DomeGitHub101/Camera_STM32/tools/tags/tag36h11_id6.png

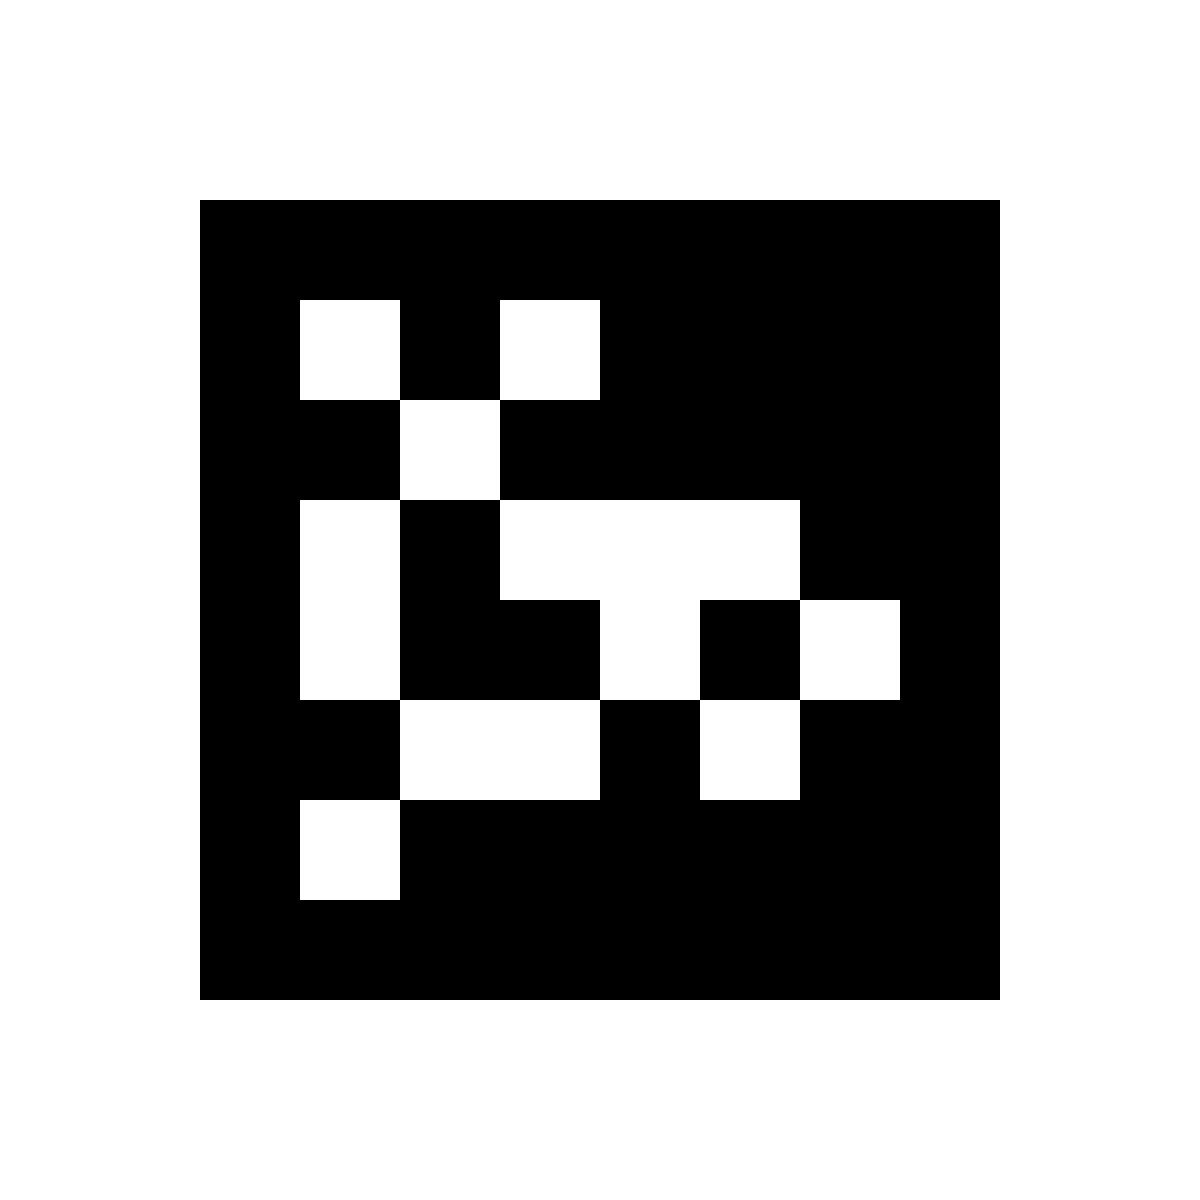
tools/tags/tag36h11_id6.png
