DomeGitHub101/Camera_STM32/tools/thai_text_preview.png

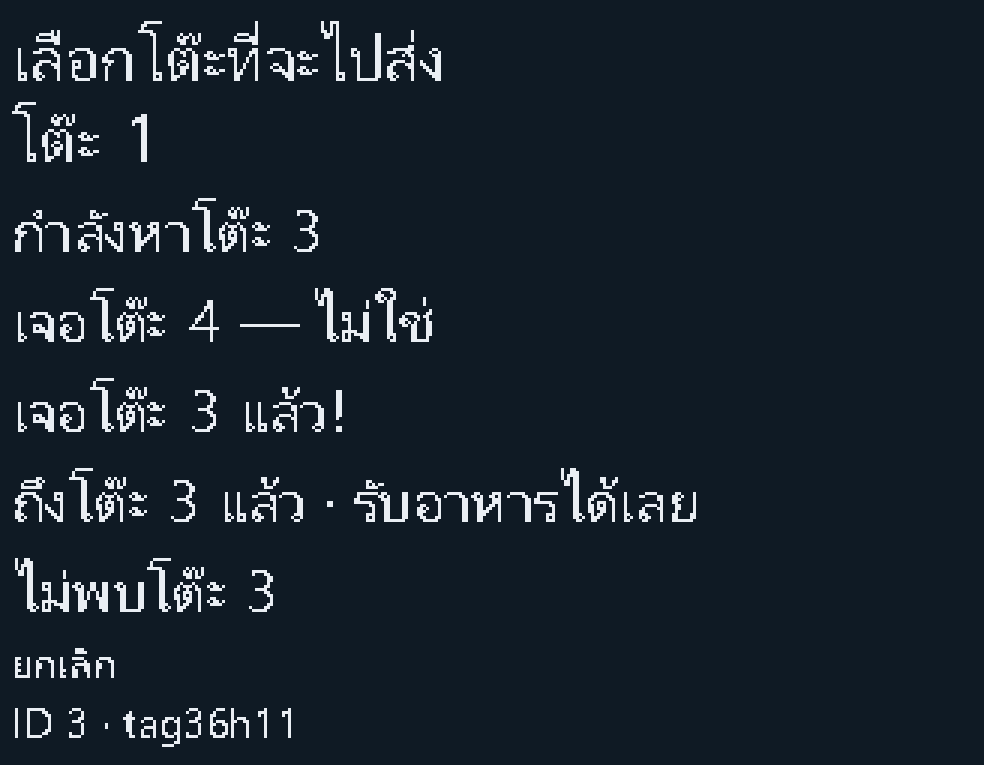
tools/thai_text_preview.png
