DomeGitHub101/Camera_STM32/Core/Src/main.c

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
/* Includes ------------------------------------------------------------------*/
#include "main.h"
#include "dcmi.h"
#include "dma.h"
#include "i2c.h"
#include "spi.h"
#include "tim.h"
#include "usart.h"
#include "gpio.h"

/* USER CODE BEGIN Includes */
#include "ov7670.h"
#include "apriltag_lite.h"
#include <stdio.h>
#include <stdlib.h>
#include <string.h>
#include "tim.h"
#include "delivery.h"
#include "cat_ui.h"
/* USER CODE END Includes */

/* USER CODE BEGIN PD */
/* ---- application ---- */
#define APP_DELIVERY       1        /* 1 = table delivery on the LCD (cat face, touch, servo, link_send)
                                       0 = tag -> command + video for tools/ov7670_viewer.py */
#define DELIVERY_VIDEO     1        /* 1 = delivery mode also sends video to the viewer (needs 2 Mbaud) */
/* ---- serial port (ST-LINK USB) ---- */
#if APP_DELIVERY && !DELIVERY_VIDEO
#define UART_BAUD          115200   /* text only (no video) */
#else
#define UART_BAUD          2000000  /* Tera Term and tools/ov7670_viewer.py must use this speed.
                                       2 Mbaud = 54 MHz / 27 exactly. Garbage? use 921600 */
#endif
/* ---- AprilTag (tag36h11) detection on the STM32 ---- */
#define DET_SCALE          1        /* 1 = detect on 320x240 (longer range), 2 = on 160x120 (faster) */
#define DET_W              (OV7670_WIDTH / DET_SCALE)
#define DET_H              (OV7670_HEIGHT / DET_SCALE)
#define CONFIRM_FRAMES     2        /* a tag must be seen this many frames in a row to become the command */
#define TAG_LOST_MS        1000     /* no command tag for this long -> STOP */
/* ---- result lines in Tera Term ---- */
#define OUTPUT_DELAY_MS    500      /* delay between result lines; change at run time with + and - */
#define OUTPUT_DELAY_STEP  100
#define OUTPUT_DELAY_MIN   100
#define OUTPUT_DELAY_MAX   10000
/* ---- live video for tools/ov7670_viewer.py (sent only after it asks with 'v') ---- */
#define VIDEO_SCALE        2        /* 1 = 320x240, 2 = 160x120; must be a multiple of DET_SCALE */
#define VIDEO_W            (OV7670_WIDTH / VIDEO_SCALE)
#define VIDEO_H            (OV7670_HEIGHT / VIDEO_SCALE)
/* ---- misc ---- */
#define BOOT_DIAG          0        /* 1 = print the SCCB / I2C scan / sync-signal tests at start-up */
#define GRAY_Y_OFFSET      0        /* which byte of each YUYV pixel pair is Y */
/* ---- camera signal checks ---- */
#define OV7670_TEST_PATTERN 0       /* 1 = colour bars instead of the picture (key p toggles at run time) */
#define OV7670_PCLK_DIV    1        /* 1 = normal, 2 / 4 = slower PCLK for long jumper wires (fewer fps) */
#define CAMERA_ROTATION    180      /* how far to turn the picture clockwise to make it upright: 0 / 90 / 180 / 270.
                                       0 = camera mounted level (landscape). If it is mounted on its side,
                                       the left/right angle is taken from the matching image axis and
                                       the viewer turns the picture (detection works in any orientation) */
#define CAM_STATS          0        /* 1 = print a CAM: line (frame size / errors) with every result line */
#define DROP_BAD_FRAMES    1        /* 1 = no tag detection on frames with wrong size or DCMI errors */
#define SHOW_BAD_FRAMES    0        /* 1 = the viewer also gets the bad frames (stripes / shifted lines) */
#define FRAME_MARGIN       (4 * OV7670_WIDTH * 2)   /* DMA room for 4 extra lines, to measure long frames */
#define CAP_BYTES          (OV7670_FRAME_BYTES + FRAME_MARGIN)
#define ROW_TOLERANCE      12       /* test pattern: mean |Y difference| for a row to count as wrong */

#if (VIDEO_SCALE % DET_SCALE) != 0
#error "VIDEO_SCALE must be a multiple of DET_SCALE"
#endif
/* USER CODE END PD */


/* USER CODE BEGIN PV */
__attribute__((aligned(32))) static uint8_t frame_buf[CAP_BYTES];   /* YUYV from the DCMI */
static uint8_t           cap_running = 0;  /* a snapshot has been started and not yet collected */
static volatile uint16_t cap_lines = 0;    /* lines (HREF pulses) received in the current snapshot */
static volatile uint32_t cap_err = 0;      /* HAL_DCMI_ERROR_* bits seen during the current snapshot */
static uint8_t           test_pattern = OV7670_TEST_PATTERN;
static uint8_t gray[DET_W * DET_H];            /* Y plane = input of the tag detector */
static uint8_t video_buf[VIDEO_W * VIDEO_H];   /* frame sent to the PC viewer */
static at_config_t    at_cfg;
static at_detection_t dets[AT_MAX_DETECT];

/* Tag ID -> robot command (other IDs are reported but give no command) */
static const char *const tag_cmd[] = {
  "STOP",         /* ID 0 */
  "FORWARD",      /* ID 1 */
  "TURN_LEFT",    /* ID 2 */
  "TURN_RIGHT",   /* ID 3 */
  "BACKWARD",     /* ID 4 */
};
#define NUM_TAG_CMDS ((int)(sizeof tag_cmd / sizeof tag_cmd[0]))

static int      active_id = -1;       /* tag ID currently driving the robot, -1 = none */
__attribute__((unused)) static int cand_id = -1;       /* tag waiting for CONFIRM_FRAMES */
__attribute__((unused)) static int cand_count = 0;
static uint32_t active_seen = 0;      /* tick when the active tag was last seen */
static uint8_t  video_mode = 0;       /* 1 = viewer connected: also send frames + @ lines */
static uint32_t output_delay = OUTPUT_DELAY_MS;

/* statistics for the result lines */
static uint32_t stat_frames = 0, stat_det_us = 0, stat_t0 = 0;
static int            last_n = 0;     /* tags found in the latest frame */
static at_detection_t last_best;      /* biggest of them */

/* frame checks since the last result line */
static struct {
  uint32_t frames, good, short_, long_, ovr, other_err, timeout;
  uint32_t lines_min, lines_max, bytes_min, bytes_max;
  uint32_t row_bad_frames, rows_bad_max, order_ok, order_bad;
} cam;
/* USER CODE END PV */

void SystemClock_Config(void);
static void MPU_Config(void);
/* USER CODE BEGIN 0 */
static void uart_print(const char *s)
{
  HAL_UART_Transmit(&huart3, (uint8_t *)s, strlen(s), 100);
}

/* Non-blocking read of one byte typed in Tera Term / sent by the viewer, -1 if none */
static int uart_getc(void)
{
  USART_TypeDef *u = huart3.Instance;
  if (u->ISR & (USART_ISR_ORE | USART_ISR_FE | USART_ISR_NE))
    u->ICR = USART_ICR_ORECF | USART_ICR_FECF | USART_ICR_NCF;
  if (u->ISR & USART_ISR_RXNE) return (int)(u->RDR & 0xFF);
  return -1;
}

/* ---- SCCB bit-bang: bus recovery at start-up (+ register test with BOOT_DIAG) ---- */
#define BB_SCL_PIN  GPIO_PIN_1   /* PF1 */
#define BB_SDA_PIN  GPIO_PIN_0   /* PF0 */
#define SCL_H()  HAL_GPIO_WritePin(GPIOF, BB_SCL_PIN, GPIO_PIN_SET)
#define SCL_L()  HAL_GPIO_WritePin(GPIOF, BB_SCL_PIN, GPIO_PIN_RESET)
#define SDA_H()  HAL_GPIO_WritePin(GPIOF, BB_SDA_PIN, GPIO_PIN_SET)
#define SDA_L()  HAL_GPIO_WritePin(GPIOF, BB_SDA_PIN, GPIO_PIN_RESET)
#define SDA_IN() (HAL_GPIO_ReadPin(GPIOF, BB_SDA_PIN) == GPIO_PIN_SET)
#define SCL_IN() (HAL_GPIO_ReadPin(GPIOF, BB_SCL_PIN) == GPIO_PIN_SET)

static void bb_delay(void)
{
  for (volatile uint32_t i = 0; i < 1000; i++) {}   /* ~5 us at 216 MHz */
}

static void bb_init(void)
{
  GPIO_InitTypeDef g = {0};
  HAL_I2C_DeInit(&hi2c2);
  __HAL_RCC_GPIOF_CLK_ENABLE();
  g.Pin = BB_SCL_PIN | BB_SDA_PIN;
  g.Mode = GPIO_MODE_OUTPUT_OD;
  g.Pull = GPIO_PULLUP;
  g.Speed = GPIO_SPEED_FREQ_LOW;
  SCL_H(); SDA_H();
  HAL_GPIO_Init(GPIOF, &g);
  bb_delay();
}

/* Bus recovery: if the camera still holds SDA low (MCU was reset in the
   middle of a transfer), clock SCL until it lets go, then send a STOP */
static void bb_recover(void)
{
  for (int i = 0; i < 9 && !SDA_IN(); i++) {
    SCL_L(); bb_delay(); SCL_H(); bb_delay();
  }
  SDA_L(); bb_delay(); SCL_H(); bb_delay(); SDA_H(); bb_delay();
}

#if BOOT_DIAG
static void bb_start(void) { SDA_H(); SCL_H(); bb_delay(); SDA_L(); bb_delay(); SCL_L(); bb_delay(); }
static void bb_stop(void)  { SDA_L(); bb_delay(); SCL_H(); bb_delay(); SDA_H(); bb_delay(); }

static int bb_write(uint8_t b)
{
  for (int i = 7; i >= 0; i--) {
    if (b & (1 << i)) SDA_H(); else SDA_L();
    bb_delay(); SCL_H(); bb_delay(); SCL_L(); bb_delay();
  }
  SDA_H(); bb_delay();
  SCL_H(); bb_delay();
  int ack = !SDA_IN();
  SCL_L(); bb_delay();
  return ack;
}

static uint8_t bb_read(void)
{
  uint8_t b = 0;
  SDA_H();
  for (int i = 0; i < 8; i++) {
    bb_delay(); SCL_H(); bb_delay();
    b = (b << 1) | (SDA_IN() ? 1 : 0);
    SCL_L();
  }
  SDA_H(); bb_delay(); SCL_H(); bb_delay(); SCL_L(); bb_delay();
  return b;
}

static void bb_read_reg(uint8_t reg, char *msg, size_t n)
{
  bb_start();
  int a1 = bb_write(0x42);
  int a2 = bb_write(reg);
  bb_stop();
  bb_start();
  int a3 = bb_write(0x43);
  uint8_t v = bb_read();
  bb_stop();
  snprintf(msg, n, "  reg 0x%02X: ACK addrW=%d reg=%d addrR=%d  value=0x%02X\r\n",
           reg, a1, a2, a3, v);
}

/* Count level changes on an input pin for 'ms' milliseconds (works in AF mode too) */
static uint32_t count_edges(GPIO_TypeDef *port, uint16_t pin, uint32_t ms)
{
  uint32_t n = 0, t0 = HAL_GetTick();
  uint32_t last = port->IDR & pin;
  while (HAL_GetTick() - t0 < ms) {
    uint32_t now = port->IDR & pin;
    if (now != last) { n++; last = now; }
  }
  return n;
}
#endif /* BOOT_DIAG */

/* ---- camera frames ----
   A snapshot is started into a buffer a few lines bigger than a frame, so
   the DMA never completes on a normal frame. The end of the frame is seen
   in the main loop when the DCMI clears CAPTURE; the DMA counter then tells
   how many bytes arrived, and the line interrupt how many lines. */
void HAL_DCMI_LineEventCallback(DCMI_HandleTypeDef *h)
{
  if (h->Instance->CR & DCMI_CR_CAPTURE) cap_lines++;
}

/* VSYNC starts the blanking before a frame: lines counted so far belong to
   the frame that was running when the snapshot was armed. At the end of the
   captured frame CAPTURE is already clear, so its count is kept. */
void HAL_DCMI_VsyncEventCallback(DCMI_HandleTypeDef *h)
{
  if (h->Instance->CR & DCMI_CR_CAPTURE) cap_lines = 0;
}

void HAL_DCMI_ErrorCallback(DCMI_HandleTypeDef *h)
{
  cap_err |= h->ErrorCode;
  h->ErrorCode = HAL_DCMI_ERROR_NONE;
}

static void start_capture(void)
{
  cap_lines = 0;
  cap_err = 0;
  HAL_DCMI_Start_DMA(&hdcmi, DCMI_MODE_SNAPSHOT, (uint32_t)frame_buf, CAP_BYTES / 4);
  /* the HAL turns these off after a frame event in snapshot mode */
  __HAL_DCMI_ENABLE_IT(&hdcmi, DCMI_IT_LINE | DCMI_IT_VSYNC | DCMI_IT_OVR | DCMI_IT_ERR);
  cap_running = 1;
}

/* Bytes the DMA took from the DCMI in this snapshot (call once CAPTURE is clear) */
static uint32_t captured_bytes(void)
{
  uint32_t t0 = DWT->CYCCNT;
  /* let the DMA empty the DCMI FIFO, at most ~100 us */
  while ((hdcmi.Instance->SR & DCMI_SR_FNE) && DWT->CYCCNT - t0 < SystemCoreClock / 10000u) {}
  return (CAP_BYTES / 4 - __HAL_DMA_GET_COUNTER(hdcmi.DMA_Handle)) * 4;
}

/* Test pattern: number of rows whose Y values differ from the middle row
   (the colour bars are vertical, so every row should be the same) */
static uint32_t count_bad_rows(void)
{
  const uint8_t *ref = frame_buf + (OV7670_HEIGHT / 2) * OV7670_WIDTH * 2 + GRAY_Y_OFFSET;
  uint32_t bad = 0;
  for (int y = 0; y < OV7670_HEIGHT; y++) {
    const uint8_t *row = frame_buf + y * OV7670_WIDTH * 2 + GRAY_Y_OFFSET;
    uint32_t diff = 0;
    for (int x = 0; x < OV7670_WIDTH * 2; x += 2) diff += (uint32_t)abs(row[x] - ref[x]);
    if (diff > ROW_TOLERANCE * OV7670_WIDTH) bad++;
  }
  return bad;
}

/* Test pattern: the first bar is white and the last black (or the other way
   round when mirrored). Both have U = V = 128, so with the right byte order
   the Y bytes differ a lot and the U/V bytes stay near 128. */
static int yuyv_order_ok(void)
{
  uint32_t y_l = 0, y_r = 0, c_l = 0, c_r = 0, n = 0;
  for (int y = 40; y < OV7670_HEIGHT - 40; y += 8)
    for (int x = 4; x < 20; x++) {
      const uint8_t *row = frame_buf + y * OV7670_WIDTH * 2;
      int xr = OV7670_WIDTH - 1 - x;
      y_l += row[x * 2 + GRAY_Y_OFFSET];
      c_l += row[x * 2 + 1 - GRAY_Y_OFFSET];
      y_r += row[xr * 2 + GRAY_Y_OFFSET];
      c_r += row[xr * 2 + 1 - GRAY_Y_OFFSET];
      n++;
    }
  y_l /= n; y_r /= n; c_l /= n; c_r /= n;
  return abs((int)y_l - (int)y_r) > 80 && abs((int)c_l - 128) < 30 && abs((int)c_r - 128) < 30;
}

/* Record the checks of one finished snapshot; 1 = frame is good */
static int check_frame(uint32_t bytes, uint32_t lines, uint32_t err)
{
  if (cam.frames == 0) {
    cam.lines_min = cam.lines_max = lines;
    cam.bytes_min = cam.bytes_max = bytes;
  }
  cam.frames++;
  if (lines < cam.lines_min) cam.lines_min = lines;
  if (lines > cam.lines_max) cam.lines_max = lines;
  if (bytes < cam.bytes_min) cam.bytes_min = bytes;
  if (bytes > cam.bytes_max) cam.bytes_max = bytes;

  int good = 1;
  if (bytes >= CAP_BYTES || lines > OV7670_HEIGHT) {
    /* also raises an overrun once the buffer is full: not counted separately */
    cam.long_++;
    good = 0;
  } else {
    if (err & HAL_DCMI_ERROR_OVR) { cam.ovr++; good = 0; }
    /* the HAL aborts the DMA after an overrun, which also sets ERROR_DMA */
    if ((err & HAL_DCMI_ERROR_SYNC) || (err & (HAL_DCMI_ERROR_DMA | HAL_DCMI_ERROR_OVR)) == HAL_DCMI_ERROR_DMA) {
      cam.other_err++;
      good = 0;
    }
    if (bytes != OV7670_FRAME_BYTES || lines != OV7670_HEIGHT) {
      if (bytes < OV7670_FRAME_BYTES || lines < OV7670_HEIGHT) cam.short_++;
      else cam.long_++;
      good = 0;
    }
  }

  if (test_pattern && bytes >= OV7670_FRAME_BYTES) {
    uint32_t rows = count_bad_rows();
    if (rows) { cam.row_bad_frames++; good = 0; }
    if (rows > cam.rows_bad_max) cam.rows_bad_max = rows;
    if (yuyv_order_ok()) cam.order_ok++;
    else cam.order_bad++;
  }
  if (good) cam.good++;
  return good;
}

__attribute__((unused)) static void print_cam_stats(void)
{
  char line[256];
  int len = snprintf(line, sizeof line,
                     "  CAM: %lu frames, %lu good | short %lu long %lu overrun %lu err %lu timeout %lu",
                     (unsigned long)cam.frames, (unsigned long)cam.good, (unsigned long)cam.short_,
                     (unsigned long)cam.long_, (unsigned long)cam.ovr, (unsigned long)cam.other_err,
                     (unsigned long)cam.timeout);
  if (cam.frames)
    len += snprintf(line + len, sizeof line - len, " | lines %lu-%lu (want %d) bytes %lu-%lu (want %d)",
                    (unsigned long)cam.lines_min, (unsigned long)cam.lines_max, OV7670_HEIGHT,
                    (unsigned long)cam.bytes_min, (unsigned long)cam.bytes_max, OV7670_FRAME_BYTES);
  if (test_pattern)
    len += snprintf(line + len, sizeof line - len, " | TEST bad-row frames %lu (max %lu rows), YUYV order %s",
                    (unsigned long)cam.row_bad_frames, (unsigned long)cam.rows_bad_max,
                    cam.order_bad == 0 ? "OK" : (cam.order_ok == 0 ? "WRONG" : "unstable"));
  snprintf(line + len, sizeof line - len, "\r\n");
  uart_print(line);
  memset(&cam, 0, sizeof cam);
}

/* VSYNC (PG9) period in microseconds, median of 5; 0 = no VSYNC */
static uint32_t measure_frame_us(void)
{
  uint32_t per[5], n = 0, t_prev = 0, t0 = HAL_GetTick();
  uint32_t last = GPIOG->IDR & GPIO_PIN_9;
  int edges = 0;
  while (n < 5 && HAL_GetTick() - t0 < 2000) {
    uint32_t now = GPIOG->IDR & GPIO_PIN_9;
    if (now && !last) {
      uint32_t t = DWT->CYCCNT;
      uint32_t us = (t - t_prev) / (SystemCoreClock / 1000000u);
      if (edges++ > 0 && us > 5000) per[n++] = us;   /* ignore glitches */
      t_prev = t;
    }
    last = now;
  }
  if (n < 5) return 0;
  for (int i = 1; i < 5; i++)                         /* sort, take the middle one */
    for (int j = i; j > 0 && per[j] < per[j - 1]; j--) { uint32_t s = per[j]; per[j] = per[j - 1]; per[j - 1] = s; }
  return per[2];
}

/* Copy the Y bytes of the YUYV frame into gray[] (every DET_SCALE-th pixel and line) */
static void extract_gray(void)
{
  uint8_t *dst = gray;
  for (int y = 0; y < OV7670_HEIGHT; y += DET_SCALE) {
    const uint8_t *src = frame_buf + y * OV7670_WIDTH * 2 + GRAY_Y_OFFSET;
    for (int x = 0; x < OV7670_WIDTH; x += DET_SCALE) *dst++ = src[x * 2];
  }
}

/* ---- tag -> command ---- */
__attribute__((unused)) static const char *cmd_text(int id)
{
  if (id < 0) return "STOP (no tag)";
  return tag_cmd[id];
}

#if !APP_DELIVERY
/* id = biggest tag with a command in this frame, -1 = none */
static void update_command(int id, uint32_t now)
{
  if (id < 0) {
    cand_id = -1;
    cand_count = 0;
    return;
  }
  if (id == cand_id) cand_count++;
  else { cand_id = id; cand_count = 1; }
  if (cand_count >= CONFIRM_FRAMES) active_id = id;
  if (id == active_id) active_seen = now;
}

/* One result line for Tera Term, every output_delay ms */
static void print_status(uint32_t now)
{
  char line[160];
  uint32_t dt = now - stat_t0;
  uint32_t fps10 = dt ? stat_frames * 10000u / dt : 0;                  /* fps x10 */
  uint32_t det10 = stat_frames ? stat_det_us / stat_frames / 100u : 0;  /* ms x10 */
  int len = snprintf(line, sizeof line, "[%6lu.%02lu s] CMD: %-13s | ",
                     (unsigned long)(now / 1000), (unsigned long)(now % 1000 / 10), cmd_text(active_id));
  if (last_n > 0)
    len += snprintf(line + len, sizeof line - len, "tag ID %d at (%d,%d) %dpx rot %d err %d%s | ",
                    last_best.id, (int)last_best.cx, (int)last_best.cy, (int)(last_best.side + 0.5f),
                    last_best.rotation, last_best.hamming, last_n > 1 ? " +more" : "");
  else
    len += snprintf(line + len, sizeof line - len, "no tag | ");
  snprintf(line + len, sizeof line - len, "detect %lu.%lu ms, %lu.%lu fps\r\n",
           (unsigned long)(det10 / 10), (unsigned long)(det10 % 10),
           (unsigned long)(fps10 / 10), (unsigned long)(fps10 % 10));
  uart_print(line);
#if CAM_STATS
  print_cam_stats();
#endif
  stat_frames = 0;
  stat_det_us = 0;
  stat_t0 = now;
}
#endif /* !APP_DELIVERY */

static void print_help(void)
{
  char line[100];
#if !APP_DELIVERY
  uart_print("tag ID -> command: 0 STOP, 1 FORWARD, 2 TURN_LEFT, 3 TURN_RIGHT, 4 BACKWARD\r\n");
#endif
  snprintf(line, sizeof line, "output delay %lu ms  (keys: + slower, - faster, p test pattern, s servo test, h help)\r\n",
           (unsigned long)output_delay);
  uart_print(line);
}

/* Keys from Tera Term (+ - h) and from the viewer (v = video on, t = text only) */
static void handle_key(int c)
{
  char line[60];
  switch (c) {
  case 'v':
#if APP_DELIVERY && !DELIVERY_VIDEO
    uart_print("@MODE TEXT\r\n");   /* no video at 115200 baud: the viewer shows the text lines */
#else
    video_mode = 1;
#endif
    break;
  case 't':
    video_mode = 0;
    uart_print("\r\nvideo off\r\n");
    break;
  case '+':
  case '-':
    if (c == '+' && output_delay + OUTPUT_DELAY_STEP <= OUTPUT_DELAY_MAX) output_delay += OUTPUT_DELAY_STEP;
    if (c == '-' && output_delay >= OUTPUT_DELAY_MIN + OUTPUT_DELAY_STEP) output_delay -= OUTPUT_DELAY_STEP;
    snprintf(line, sizeof line, "output delay = %lu ms\r\n", (unsigned long)output_delay);
    uart_print(line);
    break;
  case 'p':
    test_pattern = !test_pattern;
    OV7670_SetTestPattern(test_pattern);
    uart_print(test_pattern ? "test pattern ON (colour bars)\r\n" : "test pattern OFF\r\n");
    memset(&cam, 0, sizeof cam);
    break;
#if APP_DELIVERY
  case 's':
    delivery_servo_test();
    break;
#endif
  case 'h':
  case '?':
    print_help();
    break;
  default:
    break;
  }
}

/* ---- video for tools/ov7670_viewer.py ---- */
/* Tags found by the STM32, so the viewer can draw them (coordinates in DET_W x DET_H) */
static void send_tag_lines(int n)
{
  char line[100];
  for (int i = 0; i < n; i++) {
    const at_detection_t *d = &dets[i];
    snprintf(line, sizeof line, "@TAG %d %d %d %d %d %d %d %d %d %d %d\r\n", DET_W, DET_H, d->id,
             (int)d->corners[0][0], (int)d->corners[0][1], (int)d->corners[1][0], (int)d->corners[1][1],
             (int)d->corners[2][0], (int)d->corners[2][1], (int)d->corners[3][0], (int)d->corners[3][1]);
    uart_print(line);
  }
  snprintf(line, sizeof line, "@ROT %d\r\n", CAMERA_ROTATION);   /* the viewer turns the picture upright */
  uart_print(line);
#if APP_DELIVERY
  snprintf(line, sizeof line, "@CMD %s\r\n", delivery_status());   /* mission state for the viewer */
#else
  snprintf(line, sizeof line, "@CMD %s\r\n", cmd_text(active_id));
#endif
  uart_print(line);
}

/* AA 55 'F' 'G' | width u16 LE | height u16 LE | grey pixels | byte sum u32 LE */
static void send_video(void)
{
  const int step = VIDEO_SCALE / DET_SCALE;
  uint32_t k = 0, sum = 0;
  for (int y = 0; y < DET_H; y += step)
    for (int x = 0; x < DET_W; x += step) {
      video_buf[k] = gray[y * DET_W + x];
      sum += video_buf[k++];
    }
  uint8_t hdr[8] = {0xAA, 0x55, 'F', 'G',
                    VIDEO_W & 0xFF, VIDEO_W >> 8, VIDEO_H & 0xFF, VIDEO_H >> 8};
  HAL_UART_Transmit(&huart3, hdr, sizeof hdr, 100);
  for (uint32_t off = 0; off < sizeof video_buf; off += 32768) {
    uint32_t n = sizeof video_buf - off;
    if (n > 32768) n = 32768;
    HAL_UART_Transmit(&huart3, video_buf + off, n, 2000);
  }
  HAL_UART_Transmit(&huart3, (uint8_t *)&sum, 4, 100);
}
/* USER CODE END 0 */

/**
  * @brief  The application entry point.
  * @retval int
  */
int main(void)
{

  /* MPU Configuration--------------------------------------------------------*/
  MPU_Config();

  /* MCU Configuration--------------------------------------------------------*/

  /* Reset of all peripherals, Initializes the Flash interface and the Systick. */
  HAL_Init();

  /* USER CODE BEGIN Init */
  /* caches: the tag detector runs several times faster.
     frame_buf is written by DMA, so it is invalidated before every read */
  SCB_EnableICache();
  SCB_EnableDCache();
  /* USER CODE END Init */

  /* Configure the system clock */
  SystemClock_Config();

  /* Initialize all configured peripherals */
  MX_GPIO_Init();
  MX_DMA_Init();
  MX_DCMI_Init();
  MX_USART3_UART_Init();
  MX_I2C2_Init();
  MX_TIM2_Init();
  MX_SPI5_Init();
  MX_USART2_UART_Init();
  /* USER CODE BEGIN 2 */
#if APP_DELIVERY
  /* $M,0,0,0 to the lower board every 100 ms from now on (TIM6 interrupt):
     it keeps coming while the camera + LCD set-up below takes a few seconds,
     and a valid $M cancels the lower board's start-up wheel test */
  link_start();
#endif
  huart3.Init.BaudRate = UART_BAUD;   /* 115200 is too slow for the video to the viewer */
  HAL_UART_Init(&huart3);
  char msg[96];
  uart_print("\r\n=== OV7670 AprilTag reader (tag36h11, detection on the STM32) ===\r\n");

  /* XCLK = TIM2_CH1 PWM 13.5 MHz on PA5 (D13) */
  HAL_TIM_PWM_Start(&htim2, TIM_CHANNEL_1);
  HAL_Delay(50);

  /* free the SCCB bus if the camera still holds SDA low from before a reset */
  bb_init();
  if (!SDA_IN() || !SCL_IN()) bb_recover();
#if BOOT_DIAG
  snprintf(msg, sizeof msg, "  SCCB idle levels: SCL=%d SDA=%d (expect 1 1)\r\n", SCL_IN(), SDA_IN());
  uart_print(msg);
  /* can the board pull each line low and let it go again? (damaged pin / short) */
  {
    int scl_lo, scl_hi, sda_lo, sda_hi;
    SCL_L(); bb_delay(); scl_lo = SCL_IN(); SCL_H(); bb_delay(); bb_delay(); scl_hi = SCL_IN();
    SDA_L(); bb_delay(); sda_lo = SDA_IN(); SDA_H(); bb_delay(); bb_delay(); sda_hi = SDA_IN();
    snprintf(msg, sizeof msg, "  drive test: SCL low=%d high=%d  SDA low=%d high=%d (expect 0 1 0 1)\r\n",
             scl_lo, scl_hi, sda_lo, sda_hi);
    uart_print(msg);
  }
  bb_read_reg(0x0A, msg, sizeof msg); uart_print(msg);
  bb_read_reg(0x0B, msg, sizeof msg); uart_print(msg);
  /* a powered camera with XCLK runs its default video at once, before any SCCB set-up */
  snprintf(msg, sizeof msg, "  edges in 200 ms before set-up: PCLK=%lu HREF=%lu VSYNC=%lu XCLK(PA5)=%lu\r\n",
           (unsigned long)count_edges(GPIOA, GPIO_PIN_6, 200),
           (unsigned long)count_edges(GPIOA, GPIO_PIN_4, 200),
           (unsigned long)count_edges(GPIOG, GPIO_PIN_9, 200),
           (unsigned long)count_edges(GPIOA, GPIO_PIN_5, 200));
  uart_print(msg);
#endif
  MX_I2C2_Init();

  /* SCCB at ~10 kHz (PRESC=11, SCLL=0xC7, SCLH=0xC3 at 54 MHz): it is only used
     at start-up, and the slow speed also works with weak pull-ups */
  hi2c2.Init.Timing = 0xB042C3C7;
  __HAL_I2C_DISABLE(&hi2c2);
  hi2c2.Instance->TIMINGR = hi2c2.Init.Timing;
  __HAL_I2C_ENABLE(&hi2c2);

#if BOOT_DIAG
  uart_print("  I2C2 bus scan:");
  for (uint8_t addr = 0x01; addr <= 0x7F; addr++)
    if (HAL_I2C_IsDeviceReady(&hi2c2, (uint16_t)(addr << 1), 2, 10) == HAL_OK) {
      snprintf(msg, sizeof msg, " 0x%02X", addr);
      uart_print(msg);
    }
  uart_print("\r\n");
#endif

  /* camera registers: QVGA, then YUV (the Y bytes are the grey image) */
  uint8_t r = OV7670_Init(&hi2c2);
  if (r == OV7670_ERR_SCCB) {
    uart_print("camera: FAIL - no answer on SCCB (check SIOC=PF1, SIOD=PF0, pull-ups, 3.3V, XCLK)\r\n");
    snprintf(msg, sizeof msg, "  failed at reg 0x%02X, HAL I2C error 0x%08lX\r\n",
             ov7670_last_reg, (unsigned long)HAL_I2C_GetError(&hi2c2));
    uart_print(msg);
#if APP_DELIVERY
    uart_print("  (s = servo test still works)\r\n");
    while (1) {
      if (uart_getc() == 's') delivery_servo_test();
    }
#else
    while (1) {}
#endif
  }
  uint8_t pid = 0, ver = 0;
  OV7670_ReadReg(0x0A, &pid);
  OV7670_ReadReg(0x0B, &ver);
  if (r != OV7670_OK || OV7670_SetYUV() != HAL_OK) {
    snprintf(msg, sizeof msg, "camera: FAIL - PID=0x%02X VER=0x%02X (expect 0x76/0x73)\r\n", pid, ver);
    uart_print(msg);
    while (1) {}
  }
  snprintf(msg, sizeof msg, "camera: OK (PID 0x%02X VER 0x%02X), grey image, detection on %dx%d\r\n",
           pid, ver, DET_W, DET_H);
  uart_print(msg);

  /* cycle counter for timing the detector and the VSYNC period */
  CoreDebug->DEMCR |= CoreDebug_DEMCR_TRCENA_Msk;
  DWT->LAR = 0xC5ACCE55;
  DWT->CYCCNT = 0;
  DWT->CTRL |= DWT_CTRL_CYCCNTENA_Msk;

  /* DCMI expects COM10 = 0: VSYNC high in blanking, HREF high on data, data valid on PCLK rising */
  uint8_t com10 = 0;
  OV7670_ReadReg(0x15, &com10);
  if (com10 != 0x00) {
    snprintf(msg, sizeof msg, "  WARNING: COM10 = 0x%02X, DCMI polarity setup expects 0x00\r\n", com10);
    uart_print(msg);
  }
  if (OV7670_SetPclkDiv(OV7670_PCLK_DIV) != HAL_OK) uart_print("  WARNING: OV7670_PCLK_DIV must be 1, 2, 4 or 8\r\n");
  if (test_pattern) OV7670_SetTestPattern(1);
  HAL_Delay(200);   /* let the new clock settle */

  /* the frame period gives the real sensor clock, which sets the 50 Hz anti-flicker step */
  uint32_t frame_us = measure_frame_us();
  if (frame_us && OV7670_SetBanding50Hz(frame_us) == HAL_OK) {
    uint32_t pclk_khz = (uint32_t)((uint64_t)OV7670_FRAME_ROWS * 784u * 1000u / frame_us);
    snprintf(msg, sizeof msg, "  frame %lu.%lu ms (%lu fps max), PCLK %lu.%02lu MHz, 50 Hz anti-flicker on\r\n",
             (unsigned long)(frame_us / 1000), (unsigned long)(frame_us % 1000 / 100),
             (unsigned long)(1000000u / frame_us),
             (unsigned long)(pclk_khz / 1000), (unsigned long)(pclk_khz % 1000 / 10));
  } else {
    snprintf(msg, sizeof msg, "  WARNING: no VSYNC on PG9, 50 Hz anti-flicker not set\r\n");
  }
  uart_print(msg);
  if (test_pattern) uart_print("  TEST PATTERN ON: colour bars instead of the picture\r\n");

#if BOOT_DIAG
  snprintf(msg, sizeof msg, "  edges in 200 ms: PCLK=%lu HREF=%lu VSYNC=%lu\r\n",
           (unsigned long)count_edges(GPIOA, GPIO_PIN_6, 200),
           (unsigned long)count_edges(GPIOA, GPIO_PIN_4, 200),
           (unsigned long)count_edges(GPIOG, GPIO_PIN_9, 200));
  uart_print(msg);
#endif

  at_default_config(&at_cfg);
  print_help();
#if APP_DELIVERY
  delivery_init();   /* LCD, touch, pan servo */
#endif

  start_capture();
  uint32_t t_cap = HAL_GetTick();
  uint32_t t_out = HAL_GetTick();
  stat_t0 = t_out;
  /* USER CODE END 2 */

  /* Infinite loop */
  /* USER CODE BEGIN WHILE */
  while (1)
  {
    /* USER CODE END WHILE */

    /* USER CODE BEGIN 3 */
    int key = uart_getc();
    if (key >= 0) handle_key(key);

    /* in snapshot mode the DCMI clears CAPTURE at the end of the frame */
    if (cap_running && !(hdcmi.Instance->CR & DCMI_CR_CAPTURE)) {
      cap_running = 0;
      uint32_t bytes = captured_bytes();
      uint32_t lines = cap_lines, err = cap_err;
      HAL_DCMI_Stop(&hdcmi);
      SCB_InvalidateDCache_by_Addr((uint32_t *)frame_buf, CAP_BYTES);
      int good = check_frame(bytes, lines, err);
      extract_gray();
      /* the next frame is captured while this one is processed */
      start_capture();
      t_cap = HAL_GetTick();

      /* a bad frame gets no detection (and is not sent to the viewer unless SHOW_BAD_FRAMES) */
      int n = 0;
      if (good || !DROP_BAD_FRAMES) {
        uint32_t c0 = DWT->CYCCNT;
        n = at_detect(&at_cfg, gray, DET_W, DET_H, dets, AT_MAX_DETECT);
        stat_det_us += (DWT->CYCCNT - c0) / (SystemCoreClock / 1000000u);
        stat_frames++;

        /* biggest (= closest) tag overall, and biggest tag that has a command */
        int best = -1, best_cmd = -1;
        for (int i = 0; i < n; i++) {
          if (best < 0 || dets[i].side > dets[best].side) best = i;
          if (dets[i].id < NUM_TAG_CMDS && (best_cmd < 0 || dets[i].side > dets[best_cmd].side)) best_cmd = i;
        }
        last_n = n;
        if (best >= 0) last_best = dets[best];
#if APP_DELIVERY
        (void)best_cmd;
        delivery_frame(dets, n, DET_W, DET_H, CAMERA_ROTATION, HAL_GetTick());
#else
        update_command(best_cmd >= 0 ? dets[best_cmd].id : -1, HAL_GetTick());
#endif
      }

      if (video_mode && (good || SHOW_BAD_FRAMES)) {
        send_tag_lines(n);
        send_video();
      }
    }

    /* command tag gone for too long -> STOP */
    if (active_id >= 0 && HAL_GetTick() - active_seen > TAG_LOST_MS) active_id = -1;

    /* no end of frame for 500 ms (VSYNC missing): restart the capture */
    if (HAL_GetTick() - t_cap > 500) {
      cam.timeout++;
      HAL_DCMI_Stop(&hdcmi);
      start_capture();
      t_cap = HAL_GetTick();
    }

#if APP_DELIVERY
    /* touch, servo, face, and the TABLE / FOUND / -> $D lines every output_delay */
    delivery_poll(HAL_GetTick(), output_delay);
#if CAM_STATS
    /* frame checks (size / lines / errors) also in this mode, for chasing bad pictures */
    if (HAL_GetTick() - t_out >= output_delay) {
      char fl[48];
      uint32_t dt = HAL_GetTick() - t_out;
      snprintf(fl, sizeof fl, "  fps %lu.%lu, LCD %s\r\n", (unsigned long)(cam.frames * 1000u / dt),
               (unsigned long)(cam.frames * 10000u / dt % 10), LCD_ENABLE ? "on" : "off");
      t_out = HAL_GetTick();
      print_cam_stats();
      uart_print(fl);
    }
#else
    (void)t_out;
#endif
#else
    if (HAL_GetTick() - t_out >= output_delay) {
      t_out = HAL_GetTick();
      print_status(t_out);
    }
#endif
  }
  /* USER CODE END 3 */
}

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
 /* MPU Configuration */

void MPU_Config(void)
{
  MPU_Region_InitTypeDef MPU_InitStruct = {0};

  /* Disables the MPU */
  HAL_MPU_Disable();

  /** Initializes and configures the Region and the memory to be protected
  */
  MPU_InitStruct.Enable = MPU_REGION_ENABLE;
  MPU_InitStruct.Number = MPU_REGION_NUMBER0;
  MPU_InitStruct.BaseAddress = 0x0;
  MPU_InitStruct.Size = MPU_REGION_SIZE_4GB;
  MPU_InitStruct.SubRegionDisable = 0x87;
  MPU_InitStruct.TypeExtField = MPU_TEX_LEVEL0;
  MPU_InitStruct.AccessPermission = MPU_REGION_NO_ACCESS;
  MPU_InitStruct.DisableExec = MPU_INSTRUCTION_ACCESS_DISABLE;
  MPU_InitStruct.IsShareable = MPU_ACCESS_SHAREABLE;
  MPU_InitStruct.IsCacheable = MPU_ACCESS_NOT_CACHEABLE;
  MPU_InitStruct.IsBufferable = MPU_ACCESS_NOT_BUFFERABLE;

  HAL_MPU_ConfigRegion(&MPU_InitStruct);
  /* Enables the MPU */
  HAL_MPU_Enable(MPU_PRIVILEGED_DEFAULT);

}

/**
  * @brief  This function is executed in case of error occurrence.
  * @retval None
  */
void Error_Handler(void)
{
  /* USER CODE BEGIN Error_Handler_Debug */
  /* User can add his own implementation to report the HAL error return state */
  __disable_irq();
  while (1)
  {
  }
  /* USER CODE END Error_Handler_Debug */
}
#ifdef USE_FULL_ASSERT
/**
  * @brief  Reports the name of the source file and the source line number
  *         where the assert_param error has occurred.
  * @param  file: pointer to the source file name
  * @param  line: assert_param error line source number
  * @retval None
  */
void assert_failed(uint8_t *file, uint32_t line)
{
  /* USER CODE BEGIN 6 */
  /* User can add his own implementation to report the file name and line number,
     ex: printf("Wrong parameters value: file %s on line %d\r\n", file, line) */
  /* USER CODE END 6 */
}
#endif /* USE_FULL_ASSERT */
