DomeGitHub101/Camera_STM32/Camera_setting_with_LCD.ioc

Mcu.UserName=STM32F767ZITx
PA13.Signal=SYS_JTMS-SWDIO
PA14.Signal=SYS_JTCK-SWCLK
PA4.Signal=DCMI_HSYNC
PA5.Signal=S_TIM2_CH1_ETR
PA6.Signal=DCMI_PIXCLK
PB8.Signal=DCMI_D6
PB9.Signal=DCMI_D7
PC10.GPIO_Label=LCD_RST
PC10.Signal=GPIO_Output
PC11.Signal=DCMI_D4
PC12.GPIO_Label=LCD_DC
PC12.Signal=GPIO_Output
PC6.Signal=DCMI_D0
PC7.Signal=DCMI_D1
PC8.GPIO_Label=LCD_CS
PC8.Signal=GPIO_Output
PC9.Signal=DCMI_D3
PD3.Signal=DCMI_D5
PD5.Signal=USART2_TX
PD6.Signal=USART2_RX
PD8.Signal=USART3_TX
PD9.Signal=USART3_RX
PE0.Signal=DCMI_D2
PE2.GPIO_Label=T_IRQ
PE2.Signal=GPXTI2
PE3.GPIO_Label=T_CLK
PE3.Signal=GPIO_Output
PE4.GPIO_Label=T_DO
PE4.Signal=GPIO_Input
PE5.GPIO_Label=T_DIN
PE5.Signal=GPIO_Output
PE6.GPIO_Label=T_CS
PE6.Signal=GPIO_Output
PF0.Signal=I2C2_SDA
PF1.Signal=I2C2_SCL
PF7.Signal=SPI5_SCK
PF8.Signal=SPI5_MISO
PF9.Signal=SPI5_MOSI
PG9.Signal=DCMI_VSYNC
