DomeGitHub101/Camera_STM32/Core/Src/tag36h11_codes.c

/* tag36h11 codes (587), generated from OpenCV's DICT_APRILTAG_36h11.
   Bit order: 6x6 data cells row-major from the tag's top-left corner,
   most significant bit first, 1 = white cell. */
#include "apriltag_lite.h"

const uint32_t at_tag36h11_count = 587;

const uint64_t at_tag36h11_codes[587] = {
  0x21A146BABULL, 0x92D18FE9BULL, 0x7089014BBULL, 0x193979E27ULL,
  0x44153D3D7ULL, 0x35CD5B8CFULL, 0xA10BA56A0ULL, 0x2B874A608ULL,
  0xB57FB8D44ULL, 0x4E20B5A64ULL, 0x61D897F2CULL, 0xAB3469FFCULL,
  0x594CA45C2ULL, 0xFA1C2D2E2ULL, 0x97C24B972ULL, 0x75928624AULL,
  0x1CAAFE99AULL, 0x3236DDC16ULL, 0x884E527D6ULL, 0x5771A8C7EULL,
  0xF52925B81ULL, 0x2E59CC1A1ULL, 0x7FA58AB31ULL, 0xEB43384F9ULL,
  0x3913D5345ULL, 0xD79B1A3B5ULL, 0x0DFBE768DULL, 0x5CD7A031DULL,
  0xB9C8F7A4BULL, 0x46987E06BULL, 0x6E0C5D527ULL, 0x5BC567BB4ULL,
  0x1E6302BC2ULL, 0x8AC7D046AULL, 0xA65FE2326ULL, 0x5400EB616ULL,
  0xF7A066836ULL, 0x2DD0AFDF6ULL, 0x3B9CB60B1ULL, 0xAD6A1CAF9ULL,
  0x93B62EFB5ULL, 0xBB210D93DULL, 0xDEE55094BULL, 0xA0CD1479BULL,
  0x2A23ABB27ULL, 0x4F67F4B5FULL, 0x58A815818ULL, 0x743427D64ULL,
  0x1DEC40874ULL, 0x892AB3A02ULL, 0x38D5742EEULL, 0x0C43567A1ULL,
  0x5DB311CB1ULL, 0xC957CA1F9ULL, 0xA22457823ULL, 0x29ACE98F3ULL,
  0xCCC52C528ULL, 0xDA8B3578CULL, 0xD5B4B9E36ULL, 0xAC9CDD3CEULL,
  0xCBDAA8391ULL, 0x1986256B1ULL, 0xBAE6CC889ULL, 0xDF91B10E5ULL,
  0xA1A9D5A75ULL, 0x2B651AA9DULL, 0x4D5C2E19DULL, 0x5B163736BULL,
  0xF753D60A8ULL, 0x5E84B37D2ULL, 0xFCE43A9F2ULL, 0xBB926D1A6ULL,
  0xED8D236E5ULL, 0x6AF846F37ULL, 0xEA56A5138ULL, 0x5D497146CULL,
  0x470360ECAULL, 0x8C4BCD67AULL, 0x295F3901EULL, 0xF6B577E97ULL,
  0x520602F5AULL, 0xB5119492EULL, 0x48E299AB7ULL, 0xB79F5737AULL,
  0xA814C683EULL, 0x2DA900583ULL, 0xD4ABA4797ULL, 0x982A0E65CULL,
  0xF480CCC15ULL, 0x0B20EA732ULL, 0xA9506710AULL, 0x0486E2EE1ULL,
  0xB0A972615ULL, 0xE73F3A257ULL, 0x17E205B98ULL, 0xEC9AB2B24ULL,
  0xD9339E076ULL, 0xEB8874F99ULL, 0x9420A55CCULL, 0xE364FF992ULL,
  0x8A4CB8F0AULL, 0xF72AEE766ULL, 0x73CC6B569ULL, 0xC99CA6A59ULL,
  0x366A0C535ULL, 0x509E51943ULL, 0xBA6D227D1ULL, 0xD2ACF163BULL,
  0xD989FEF68ULL, 0x641707BB2ULL, 0xF9BD312ABULL, 0x77739C207ULL,
  0x68BF8D1BFULL, 0xDEDD84A6EULL, 0x42EAEC49BULL, 0x302B68D53ULL,
  0x4EBB930CEULL, 0x439C5D9B5ULL, 0xE1FC9228DULL, 0xF8A6A8D4AULL,
  0xB53902A18ULL, 0xB163475EEULL, 0xAD2F5AF29ULL, 0xAAB5DC850ULL,
  0xB3EC25786ULL, 0x4799C4405ULL, 0x8BC68DC04ULL, 0x702F15DDEULL,
  0xB42293DA9ULL, 0x1ACAD0382ULL, 0x813363971ULL, 0x0E692AD70ULL,
  0x8AD05C5B9ULL, 0x85E654C1BULL, 0x3D0AC2B3BULL, 0x4BBFA0552ULL,
  0x722DDE306ULL, 0x369D1ACD2ULL, 0xA2D994E60ULL, 0x5FAD9139DULL,
  0x57535AE96ULL, 0x5F5EF1D46ULL, 0xEBC3E6ACCULL, 0x0A99C835DULL,
  0x5463E49A5ULL, 0x25676893AULL, 0xABED37064ULL, 0x59BDDED94ULL,
  0x64FA04C09ULL, 0x250E44E75ULL, 0xE58A374BCULL, 0x24CAA5741ULL,
  0xE42CF6588ULL, 0x6EA238538ULL, 0xF75813025ULL, 0x0CEB33BBDULL,
  0x786AE8670ULL, 0xF0DE8C969ULL, 0x26C81EFE6ULL, 0x69F489086ULL,
  0x3FBF92A4DULL, 0xD6555A760ULL, 0x9CCAE236DULL, 0xB256C16A3ULL,
  0xD78AC7221ULL, 0x2DC1FE262ULL, 0xAF2051090ULL, 0x932C08AFEULL,
  0x53FECA775ULL, 0x5D292497AULL, 0x2F101A22BULL, 0xC6AD16B14ULL,
  0xD2ECA4B20ULL, 0xA6FA603D4ULL, 0x3057C3B69ULL, 0xE817B54D2ULL,
  0x40ABFC3E0ULL, 0xF53AD16E7ULL, 0x36F3A06E8ULL, 0x27782E418ULL,
  0x3E9062146ULL, 0x01FD7AD4EULL, 0xC8765BC64ULL, 0xAD3D8215FULL,
  0x96317A27EULL, 0x05F813CA6ULL, 0x0E7ADC22EULL, 0xBF52C4A50ULL,
  0x724F6AE2EULL, 0x540FD7EA8ULL, 0x9C962F741ULL, 0x264042B01ULL,
  0x197CB7754ULL, 0x1F2BB850DULL, 0xC87D6C2ADULL, 0xDC8D2DEDEULL,
  0xCB6B01738ULL, 0xBE4210368ULL, 0xBB4622A77ULL, 0x733226EF8ULL,
  0x4933ADE39ULL, 0x1F1C896C7ULL, 0x897665ABAULL, 0x92F46BA12ULL,
  0x297981767ULL, 0xAD702CF8DULL, 0x473198B90ULL, 0xEC2E8E06BULL,
  0x36A1D6980ULL, 0xA5CE8650FULL, 0x637870348ULL, 0xF3AB41D46ULL,
  0xE6032A8B5ULL, 0x4C11EEC73ULL, 0x261DE50D6ULL, 0x296616E32ULL,
  0x37CFF1A0AULL, 0xC457847ABULL, 0x776E52FF9ULL, 0x980819BB9ULL,
  0x50CB2B5D8ULL, 0x8B6918063ULL, 0x12D9C2CE9ULL, 0x158C2E738ULL,
  0x6B84015EAULL, 0x67695DB9FULL, 0x3E72745C1ULL, 0x01CA1A571ULL,
  0x22E7036F5ULL, 0xD5DCEDAE1ULL, 0x809532C5BULL, 0xF7E4E9D54ULL,
  0x59D84F9CBULL, 0xF42ED0851ULL, 0x5DB4A91FAULL, 0x0D58E5B1FULL,
  0x69FB9FA43ULL, 0x29BA51F60ULL, 0x587C67427ULL, 0xD8B9021EDULL,
  0xBB594449EULL, 0xAA231F35AULL, 0x0D95943F4ULL, 0xDEC461257ULL,
  0x05A16930DULL, 0xE2512EB58ULL, 0xAB48E2DC0ULL, 0x0CB68494FULL,
  0x927A6B5B1ULL, 0xBB90F3450ULL, 0x632E8FAD0ULL, 0xC2EEAF2A7ULL,
  0x1EB2AF39DULL, 0x511548C52ULL, 0x4693D5DE4ULL, 0x888E9161DULL,
  0x68836FF4FULL, 0x51BD2E441ULL, 0x7A0AC40E9ULL, 0x8BB762B4AULL,
  0x1CAF83A1AULL, 0xC2700BBBDULL, 0xFB2ED09AAULL, 0xF8520294EULL,
  0x7AA104CA6ULL, 0x6A96D2BCBULL, 0x28F2EC75EULL, 0x607065EB4ULL,
  0x7AD9B3A8CULL, 0x3572D6CBFULL, 0xD426EFB8FULL, 0x64EE4DBAAULL,
  0x983D7A8F1ULL, 0x8CA31F499ULL, 0x025457B46ULL, 0xD53AE4149ULL,
  0x9D3C64396ULL, 0x795332EE5ULL, 0x70884D664ULL, 0x1DD3528D8ULL,
  0xD8E51D246ULL, 0xD6029CA38ULL, 0xD94AB610CULL, 0x766BB8880ULL,
  0xFD0C6B319ULL, 0x3BFF8B9D1ULL, 0xE786F4D4EULL, 0xD4E6B9B79ULL,
  0xCFA8BB369ULL, 0x20A4366C6ULL, 0x5CEFB9536ULL, 0x0F06B6605ULL,
  0xBB51D25E7ULL, 0xF7E262641ULL, 0x81FDA9855ULL, 0x2241DBC59ULL,
  0x56FB4B280ULL, 0xEDA64C6D0ULL, 0xCE7B080F4ULL, 0x6192EE7E9ULL,
  0x943FF5124ULL, 0x88B3BEADFULL, 0x9B27E58D0ULL, 0xBE0B45FD2ULL,
  0x69FB3A72AULL, 0x61383A832ULL, 0x6688639B3ULL, 0x54D01C992ULL,
  0x90B10C02AULL, 0xF667FC6D1ULL, 0x7ACD75813ULL, 0x3ABD07F61ULL,
  0x543012473ULL, 0x067794D58ULL, 0xA855B1201ULL, 0x9CB4D7FDBULL,
  0x31A193E6AULL, 0x3DA3B76D4ULL, 0x4153F1E04ULL, 0x5544335B5ULL,
  0x92F61249DULL, 0x269A35F8AULL, 0x042677896ULL, 0x9487CDC6FULL,
  0x4EA7E7D9CULL, 0x2E367345BULL, 0x3A5E8F304ULL, 0x76D9FAA77ULL,
  0x64E4EA1DFULL, 0x12A7B434DULL, 0x4973D9553ULL, 0xCDB418975ULL,
  0x8BDA76D2EULL, 0xF54A4DEC8ULL, 0x811616F8AULL, 0x4036F4E6BULL,
  0x2736282A6ULL, 0xA413D229FULL, 0x901FE4C17ULL, 0x9ABFCE56EULL,
  0x2D325B9EFULL, 0xD9901F6A9ULL, 0x3AA64FADEULL, 0x65288D60BULL,
  0x0A53E960BULL, 0xE9E09C3E4ULL, 0x4D9B7863DULL, 0xD98BB4833ULL,
  0x34B181ED7ULL, 0x5B373F490ULL, 0x8572B7B91ULL, 0x2C5D056A4ULL,
  0xE4671296DULL, 0x2A08D6F78ULL, 0x452949C61ULL, 0x2501EC5B7ULL,
  0xB8F54779CULL, 0xA3B7EA4B3ULL, 0x443D6B9B4ULL, 0xBE2DCB848ULL,
  0xB51FC47ECULL, 0x6F38CF988ULL, 0x90F2FE934ULL, 0x07FD540ABULL,
  0xEE53C3D08ULL, 0xF7098EBCAULL, 0x65467C309ULL, 0xAE6FD797EULL,
  0x8BC4739E9ULL, 0x971930FE4ULL, 0x9A752DF57ULL, 0xBD47FE53EULL,
  0x6F1530928ULL, 0x5DE1CC489ULL, 0x111CE3DCDULL, 0xA4C7E157CULL,
  0x552691112ULL, 0x9D6511805ULL, 0x6663C1CB3ULL, 0xBFC594002ULL,
  0x3A3500387ULL, 0x76D4F679CULL, 0x446F2667BULL, 0x17AE59E97ULL,
  0x36132D63EULL, 0x8E07492BFULL, 0x188ACDDF1ULL, 0xED9052D02ULL,
  0x5B6BD01F5ULL, 0x84A4D070EULL, 0xC9B2A3AF4ULL, 0xAB18852FCULL,
  0x9DE918390ULL, 0x3576EE9E0ULL, 0xE8D00D210ULL, 0x709B5A95CULL,
  0xA9022A314ULL, 0xA03EA2B9CULL, 0x1E589EC5EULL, 0x74470EEDDULL,
  0x36BD44159ULL, 0xB7F8D2516ULL, 0xDCDE4BFA5ULL, 0x9EDA99C30ULL,
  0x8FFB98A8BULL, 0x9AC777E71ULL, 0x8D0A53CB3ULL, 0xC9ED1DCEDULL,
  0xC238535EAULL, 0xEE4AA6437ULL, 0xCD8345A1EULL, 0x5A19E05AEULL,
  0x96D780D25ULL, 0xE2C885185ULL, 0xC5314F8DBULL, 0xA47C37EE1ULL,
  0x1D82C6F8CULL, 0x325C5C6C8ULL, 0x5D9D1BAE0ULL, 0x9549E075EULL,
  0x8A6845C15ULL, 0xADF9F10FEULL, 0x95CEF30B0ULL, 0x71933B20DULL,
  0x1F0DE3A6FULL, 0x596F5BBA6ULL, 0xCD61D9F34ULL, 0xA478AD328ULL,
  0xDADE4012FULL, 0xD15764370ULL, 0x3A2BF5D22ULL, 0x2303E348DULL,
  0x41B9BF9A9ULL, 0x5A4E93EE3ULL, 0x462B44512ULL, 0x4E01719C1ULL,
  0x73A0D9137ULL, 0x932B416DDULL, 0xFF4B615A7ULL, 0x2C880F1ACULL,
  0x6F3BB6AA1ULL, 0x476D21AE6ULL, 0xF9C290688ULL, 0x768111210ULL,
  0x623458F55ULL, 0xF31919E1FULL, 0xEF47A7DD1ULL, 0xC6C777808ULL,
  0xEEC96F096ULL, 0x9B3C9BDAFULL, 0x6FD432573ULL, 0x60E7D0AA9ULL,
  0x0651CDA34ULL, 0xE2ACC04E7ULL, 0x9460D1A22ULL, 0x82B79B177ULL,
  0x4EB189F4BULL, 0xCBF9C3B1EULL, 0x6F6C64841ULL, 0xE54E50A2EULL,
  0x632F30F23ULL, 0xB3BB3DE6CULL, 0x6331F5383ULL, 0xBCA1DAFE5ULL,
  0xD1816CAB9ULL, 0x0D8407ACAULL, 0x794E1D7E5ULL, 0x92DE65442ULL,
  0x651497949ULL, 0x33F751712ULL, 0x3C9CE9195ULL, 0x7ECB81D7AULL,
  0xEDE140178ULL, 0xC09B0EE2CULL, 0x14E61F774ULL, 0x6D336649AULL,
  0x865DD0880ULL, 0xF7214BFB8ULL, 0xD8B9C2E22ULL, 0x99A70737FULL,
  0xC0ECF90C9ULL, 0xBB8B26E01ULL, 0x05678FCACULL, 0x33B483834ULL,
  0xEB9D84B83ULL, 0x7CA277EA2ULL, 0x02AF5F66BULL, 0x4A678C122ULL,
  0x121592BF3ULL, 0xCC82B48C9ULL, 0x77CBE90FCULL, 0x5EF7D7931ULL,
  0x117947995ULL, 0x344D5F970ULL, 0xDF2F12E72ULL, 0x114277B37ULL,
  0x0B8FA73D5ULL, 0x36E16F423ULL, 0x057402B7EULL, 0xC342423A7ULL,
  0x758C34DABULL, 0x67DC61614ULL, 0x29B222068ULL, 0x7101AF0FAULL,
  0x54D22BC75ULL, 0x908BA3AF9ULL, 0xEB68C9B51ULL, 0x2605D442CULL,
  0x6AB88B7F4ULL, 0x207C7657DULL, 0x377940D20ULL, 0xAC2EB77B6ULL,
  0x3E87318ECULL, 0x47AFEA1AAULL, 0x46DE35B74ULL, 0x48A36BA10ULL,
  0xF0711536BULL, 0x963F87ED4ULL, 0xD83AB9965ULL, 0x7B2EB5A0FULL,
  0xB6ADFAF32ULL, 0x87E07A4EAULL, 0x7B4518F4EULL, 0x9064A3738ULL,
  0x3C242CA12ULL, 0x96B25C4A4ULL, 0x8B01D83ACULL, 0xE51CCEB25ULL,
  0x480F58DB0ULL, 0xBAE295867ULL, 0x89FC0FBA0ULL, 0xDD06475E9ULL,
  0xF7FE46B4CULL, 0x43CEF026DULL, 0x6393585A2ULL, 0x87B404456ULL,
  0x4FA47CBEAULL, 0x7619F955AULL, 0x51B9A1330ULL, 0x1533637C7ULL,
  0x7587A972AULL, 0x60DE11622ULL, 0x7D4CE68AEULL, 0xAF135E81CULL,
  0x31C9B647CULL, 0xAC43D8155ULL, 0xD853E1CFBULL, 0x4FCDC5CF0ULL,
  0xEE696FD2DULL, 0xB71618475ULL, 0xB9B4B8781ULL, 0x328579505ULL,
  0x95E947771ULL, 0x9AA0302E2ULL, 0xEC1828D17ULL, 0xBC5079635ULL,
  0x8785C1B79ULL, 0xD37AADB7AULL, 0x817F02CE0ULL, 0xFD63DFB0AULL,
  0x510AC1AF2ULL, 0x3D1EDF8D3ULL, 0xF4B73A402ULL, 0x37D789E9CULL,
  0x8F11C77CAULL, 0xC4BD036BEULL, 0x7DFA995C9ULL, 0x7B14E8251ULL,
  0xCA070E7F4ULL, 0x5C22DBCD5ULL, 0xA0DB726C8ULL, 0x6B7776DE2ULL,
  0x80F58E748ULL, 0xE1AC1FF4AULL, 0x1BBAEA85CULL, 0x26AC557FCULL,
  0xE5D1EF357ULL, 0x1F29D4E10ULL, 0x459FBB15BULL, 0xD4B049559ULL,
  0x6CB70ACF8ULL, 0xF8617A518ULL, 0xC391DAC34ULL, 0x51235E2CCULL,
  0x74407C4FEULL, 0xDF1609A24ULL, 0xCED27DC17ULL,
};
