DomeGitHub101/Camera_STM32/(commit log)

2026-10-20 OV7670 camera capture on NUCLEO-F767ZI (DCMI + DMA, SCCB on I2C2)
    - XCLK 13.5 MHz from TIM2_CH1 PWM on PA5 (MCO1 removed)
    - I2C2 on PF0/PF1 with pull-ups, slowed to ~10 kHz for SCCB
    - OV7670 driver: QVGA RGB565, SCCB read without repeated start,
    retries on NACK
    - Startup diagnostics: bit-bang SCCB test with bus recovery,
    I2C bus scan, sync-signal edge counts, DCMI/DMA status per second
    - DCMI snapshot capture with restart watchdog (~17 fps)
2026-10-20 Stream grayscale frames over UART and detect AprilTags on the PC
    Firmware:
    - USART3 raised to 2 Mbaud for image transfer
    - send_frame(): header + pixels + checksum, sent while DCMI is stopped
    - Grayscale mode: OV7670 switched to YUV422 (OV7670_SetYUV), only the
    Y byte is sent (1 byte/pixel); RGB565 still available (SEND_GRAY 0)
    - Optional 2x downscale to 160x120 (SEND_SCALE)
    PC (tools/ov7670_viewer.py):
    - Parses frames from the serial stream, prints the board log
    - Detects AprilTag 36h11 with cv2.aruco, maps tag IDs to robot commands
    - Draws a coloured box and label around tags 1-4
    - tools/tags/: tag36h11 ID 1-4 images for testing
2026-10-21 Detect AprilTags and decide robot commands on the STM32
    - apriltag_lite.c: tag36h11 detector for the MCU (no malloc, static
    buffers): adaptive threshold, outline tracing, quad fit, homography,
    cell sampling, code matching with up to 2 bit errors
    - tag36h11_codes.c: all 587 codes, generated from OpenCV's dictionary
    - main.c: Y plane from the YUV frame, detection every frame, tag ID ->
    command (confirmed over 2 frames, STOP after 1 s without a tag),
    result line to Tera Term every OUTPUT_DELAY_MS (+/- keys change it)
    - Video to the PC only on request ('v'/'t'), with @TAG/@CMD lines
    - I/D cache enabled, detector compiled with -O2
    - ov7670_viewer.py: display only, draws the tags reported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
2026-10-21 Add README: pinout, wiring guide and setup
2026-10-24 Add LCD table-delivery mode and camera frame checks
    Camera:
    - Detect frame-end by the DCMI CAPTURE bit, measure bytes (DMA counter)
    and lines (line IRQ) per frame, drop wrong-size / overrun frames
    - Colour-bar test pattern (key p), PCLK divider, 50 Hz anti-flicker
    computed from the measured VSYNC period
    - Keep PA5 Very High speed and the SCCB pull-ups in USER CODE so a
    CubeMX regeneration does not drop them
    LCD delivery mode (APP_DELIVERY):
    - ILI9341 + XPT2046 (course Lec11 library, SPI5, CS PC8 / RST PC10 /
    DC PC12, touch PE2-PE6 with EXTI2)
    - Table select page and cat-face mission page, partial redraws only
    - Pan servo on PD14 (TIM4_CH3): 15 s search sweep, follows only the
    targ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
2026-10-24 Drive hints toward the tag, steady bearing, sideways camera
    - decide_drive(): MOVE CLOSER / MOVE BACK / TURN LEFT / TURN RIGHT /
    HOLD from the target's bearing and distance; the same {speed, turn}
    goes out through link_send(). Arrived = centred at TARGET_DIST_MM
    (800 +- 100 mm) for 1 s
    - Bearing no longer drifts: the servo stays still inside a deadband,
    jumps onto the tag outside it, and frames taken while it moves are
    not used. PAN_SERVO_ENABLED = 0 while no servo is fitted
    - Distance calibrated: 142 mm tag, focal 418 px
    - CAMERA_ROTATION: the camera is soldered on its side (270); the
    bearing uses the matching image axis and the viewer turns the
    picture upright (@ROT line)
2026-10-25 README: wiring for the ILI9341 LCD + touch, pan servo and the lower-board UART
2026-10-25 LCD: "received" button and return to the start point
    - At the table the cat face shows a "รับอาหารแล้ว" button; a touch (or
    RECEIVE_TIMEOUT_MS) sends the robot back to the start-point tag
    (HOME_TAG_ID 0) with the same search / drive logic
    - New status lines "กำลังกลับจุดเริ่มต้น" and "ถึงจุดเริ่มต้นแล้ว"
    (Thai bitmaps regenerated); no wrong-tag warnings on the way back
    - Result lines RECEIVED / RECEIVE TIMEOUT / RETURN / ARRIVED home
2026-10-26 Talk to the lower board over USART2; fix XCLK coupling into PCLK
    Lower-board link (USART2, PD5 TX / PD6 RX, 115200 8N1):
    - $M,left,right,mode*XX every 100 ms from the TIM6 interrupt, from boot
    on (cancels the lower board's start-up wheel test); the main loop only
    sets the newest command and the interrupt sends stop if it goes quiet
    for 400 ms
    - Wheel percentages from the drive decision (forward 20-40 %, spin 30 %,
    reverse 25 %); mode 2 near the stop point so the ToF stays quiet
    - $O,level,dist_mm*XX read back: level >= 2 pauses the mission and shows
    "กรุณาหลบหน่อยครับ"; no $O for 1 s shows "บอร์ดล่างไม่ตอบ"
    - LINK_DEBU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
2026-10-27 Stop-scan-move search, 360 turn home, smooth pan servo, LCD self-check
    - Search: wheels stop, the servo scans 180 deg in 20 deg steps (stand still
    600 ms each), nothing found -> drive straight 1.5 s, scan again; no time
    limit, only CANCEL stops it. Arrived = distance within tolerance.
    - Going home: slow 360 turn on the spot in spin/look steps (WHEEL_SPIN 50),
    stops as soon as the home tag shows up, then searches as above.
    - Pan servo moved by the TIM4 interrupt every 20 ms at a capped speed, so it
    no longer jerks with the camera frame rate; smooth tag tracking with gain
    and deadband; 's' key servo test (also works when the camera fails).
    - Camera mounted upside down: CAMERA_ROTATIO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
