DomeGitHub101/Camera_STM32/(notices)

Notices in the files:
Core/Src/tim.c:
Copyright (c) 2026 STMicroelectronics.
All rights reserved.
This software is licensed under terms that can be found in the LICENSE file
